espressif/esp-moonlight/docs/en/index.rst

ESP-Moonlight
=============

:link_to_translation:`zh_CN:[中文]`

ESP-Moonlight Support Policy
-----------------------------

From December 2023, we will offer limited support on this project, but Pull Request is still welcomed!

Supported versions and chips
-----------------------------

+---------------+-------------------+---------------+-----------------+
| ESP-Moonlight | Dependent ESP-IDF |    Target     |  Support State  |
+===============+===================+===============+=================+
| master        | >=release/v4.4    | ESP32 ESP32S3 | Limited Support |
+---------------+-------------------+---------------+-----------------+

Get Started
------------

.. role:: bolditalics
   :class: bolditalics

| **Building Products with ESP32** :bolditalics:`fast`: MoonLight

+------------------+
| _ |
+------------------+
| `Jumpstart Now`_ |
+------------------+

.. toctree::
   :hidden:

   Introduction <introduction>
   Getting Started <gettingstarted>
   The Driver <drivers>
   Wi-Fi Connection <wifi>
   Network Configuration <networkconfig>
   Remote Control (LAN) <remotecontrol_lan>
   Firmware Upgrades <firmwareupgrade>
   Speech Recognition <speech_recognition>


.. _Jumpstart Now: introduction.html
