espressif/esp-moonlight/docs/zh_CN/index.rst

ESP-Moonlight
=============

:link_to_translation:`en:[English]`

ESP-Moonlight 支持政策
-----------------------

自 2023 年 12 月起，我们仅提供有限的支持，但是 Pull Request 仍然是被欢迎的！

支持的版本和芯片
-----------------

+---------------+-------------------+---------------+-----------------+
| ESP-Moonlight | Dependent ESP-IDF |    Target     |  Support State  |
+===============+===================+===============+=================+
| master        | >=release/v4.4    | ESP32 ESP32S3 | Limited Support |
+---------------+-------------------+---------------+-----------------+

快速入门
--------

.. role:: bolditalics
   :class: bolditalics

| **快速构建 ESP32 产品**： MoonLight

+------------------+
| _ |
+------------------+
| `Jumpstart Now`_ |
+------------------+

.. toctree::
   :hidden:

   简介 <introduction>
   入门指南 <gettingstarted>
   驱动程序 <drivers>
   Wi-Fi 连接 <wifi>
   网络配置 <networkconfig>
   远程控制（局域网） <remotecontrol_lan>
   固件升级 <firmwareupgrade>
   语音识别控制 <speech_recognition>


.. _Jumpstart Now: introduction.html
