espressif/esp-moonlight/docs/zh_CN/introduction.rst

简介
============

ESP-Moonlight：使用 ESP32 快速构建一个月球灯
---------------------------------------------

ESP-Moonlight 是乐鑫推出的基于 ESP32 开发的月球灯示例项目，内含产品开发的完整步骤、最佳做法，可实现驱动 LED 灯、局域网内使用小程序端控制灯的亮度和色彩等功能。本项目以快速开发为特点，硬件结构简单，代码架构清晰完善，方便功能扩展，可用于教育领域。

esp-moonlight

    ESP-Moonlight

本项目中的月球灯有以下功能：

- 板载自动下载电路
- 电池充电功能
- 支持手机进行配网
- 支持手机控制
- 支持触碰控制
- 支持 OTA 升级
- 支持语音唤醒控制

开发板介绍
-----------

本项目使用的是 ESP32-Moonlight V2.0 开发板。

front

    ESP32-Moonlight 开发板正面

back

    ESP32-Moonlight 开发板背面
