espressif/esp-moonlight/model_3d/esp-moonlight-bottom-V2.1.stl

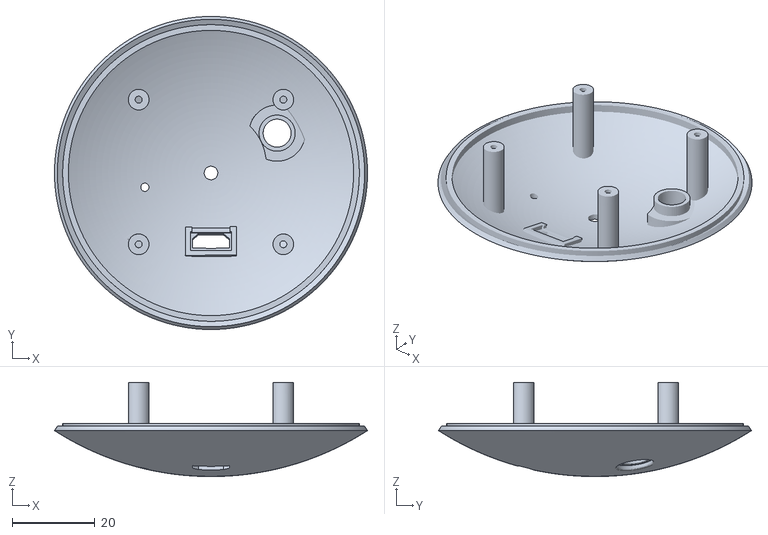
[picture p15: CAD file, 2020-07-27]
model_3d/esp-moonlight-bottom-V2.1.stl
75.7 x 75.7 x 22.8
