espressif/esp-moonlight/(list of files, cad)

Other CAD files:
model_3d/ESP-Moonlight-bottom_V2.0.stl
