espressif/esp-moonlight/(threads)

Thread 2 (2020-05-21):

例程recognize编译失败

2502797718, 2020-05-21:
提示是缺失一堆数学函数sin,log之类。

zhouli-esp, 2020-05-22:
If you can provide debug logs in the monitor, it will help solve the problem.
there are two tips:
 - Check your ESP-IDF version is [release/v4.0](https://github.com/espressif/esp-idf/tree/release/v4.0).
 - In addition, you can try to use the latest commit

2502797718, 2020-05-22:
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
[编译时错误信息.txt](https://github.com/espressif/esp-moonlight/files/4665932/default.txt)
这是编译信息，用的是v4.0

2502797718, 2020-05-22:
最新版本的源码可以编译通过

zhouli-esp, 2020-05-22:
This error may be due to  some problems in CMakeLists.txt. The latest code is recommended

zhouli-esp, 2020-05-28:
@2502797718 If your question is resolved, please close the issue. Thanks!

Closed 2020-05-28.

Thread 3 (2020-05-28):

speech_recognition 无法进行正常识别

hljswl, 2020-05-28:
1. 开发环境
模组或开发板：esp-moonlight开发板
ESP-IDF 版本：cd4fa46f5 / ESP-IDF v4.2-dev-1303-gcd4fa46f5-dirty
2. 问题描述
编译最新例程里面的 7_recognition 后不能进行语音识别。关键字唤醒没有反应。

zhouli-esp, 2020-05-28:
Now, the esp-moonlight based on ESP-IDF release/v4.0. Please see https://github.com/espressif/esp-moonlight/blob/master/docs/zh_CN/gettingstarted.rst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

Closed 2020-05-28.

Thread 5 (2022-06-20):

请问这个板子配网成功之后控制的APP在哪里下载呀

IcyFeather233, 2022-06-20:
在https://www.bilibili.com/video/BV1nQ4y1N7ZC?vd_source=145390bc56084552ecc0a576248fd1a1 这个视频教程的最后出现了一款“小夜灯”APP用来控制，但是我找不到这个APP的下载地址

IcyFeather233, 2022-06-20:
是我没注意，这个是那个微信小程序里面的

Closed 2022-06-20.
