espressif/esp-moonlight/hardware/ESP-Moonlight_V2.0_N_XX_20200421_V0.3/02_PCB Layout/PCB_ESP-Moonlight_V2.0_20200421.pdf

39.00mm

# C8C⁸x1C⁸x2

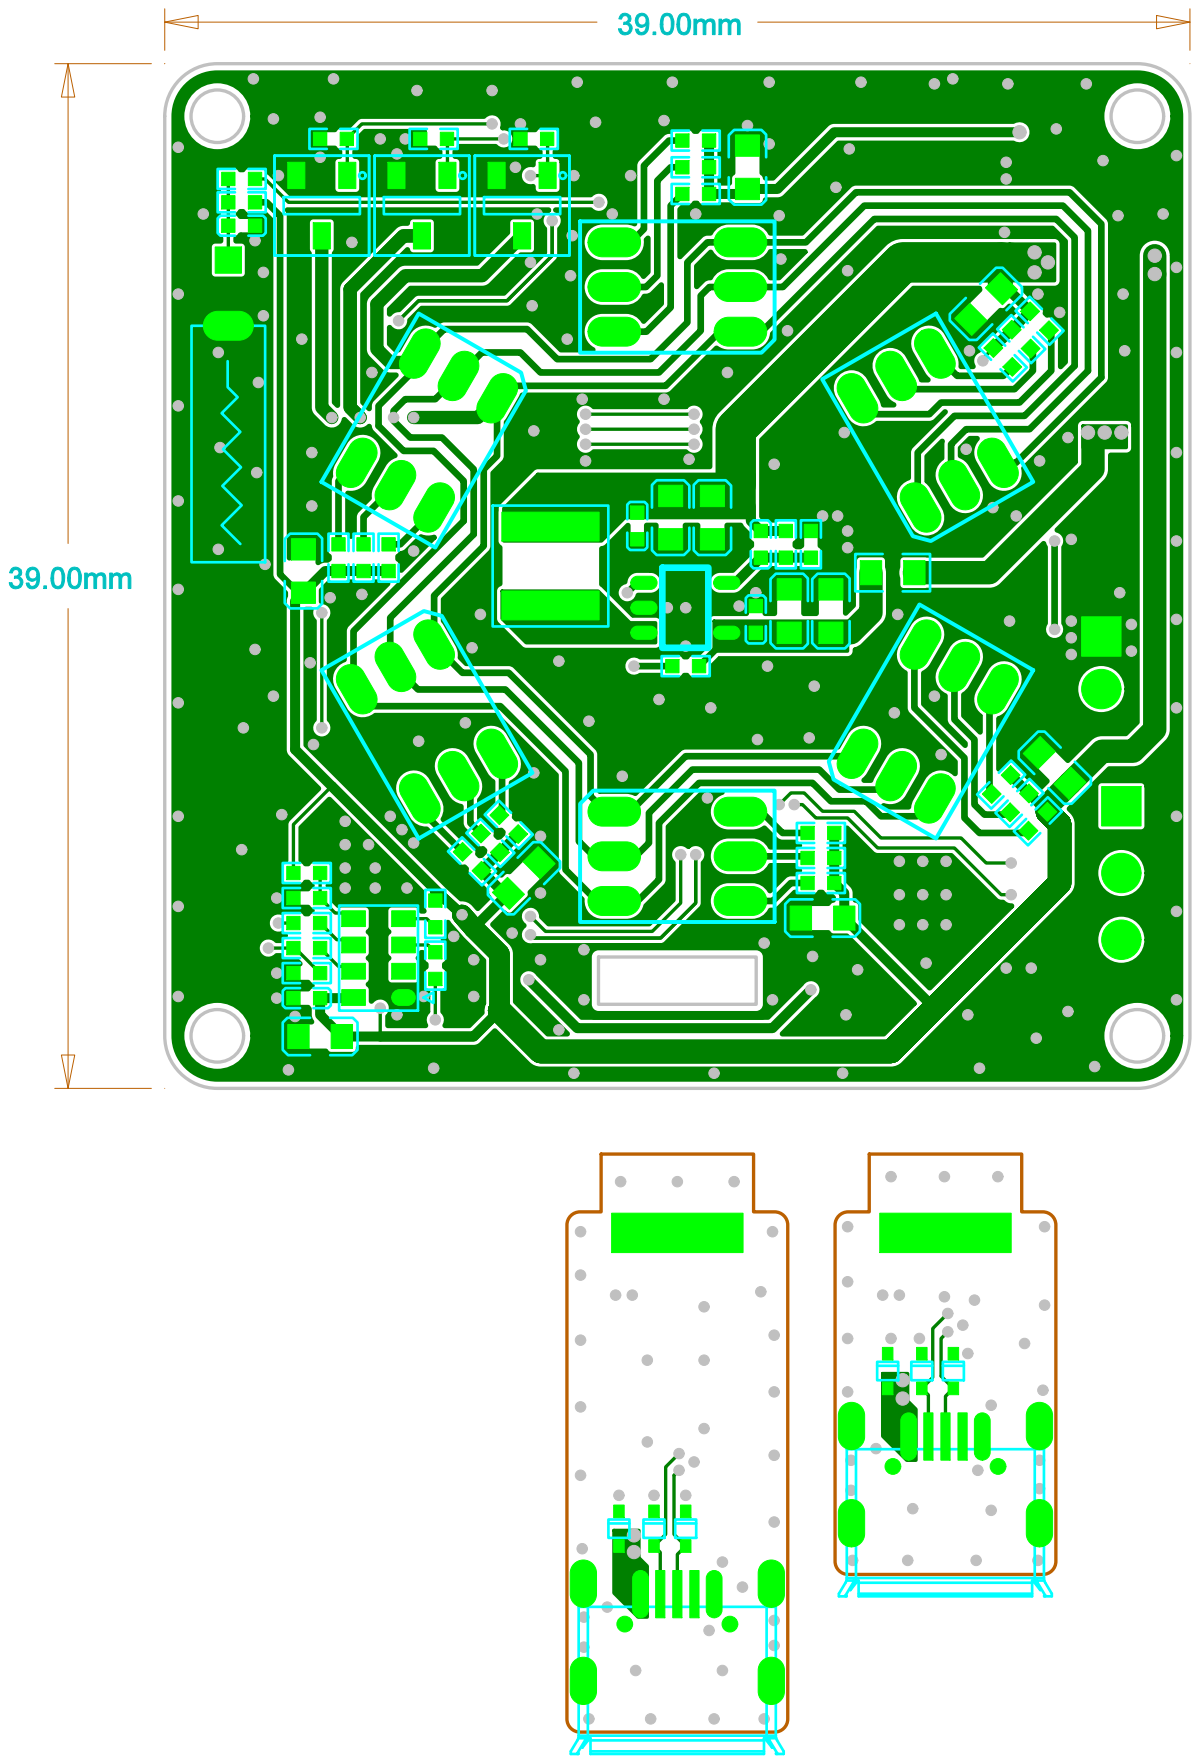
[picture p19: page 1]

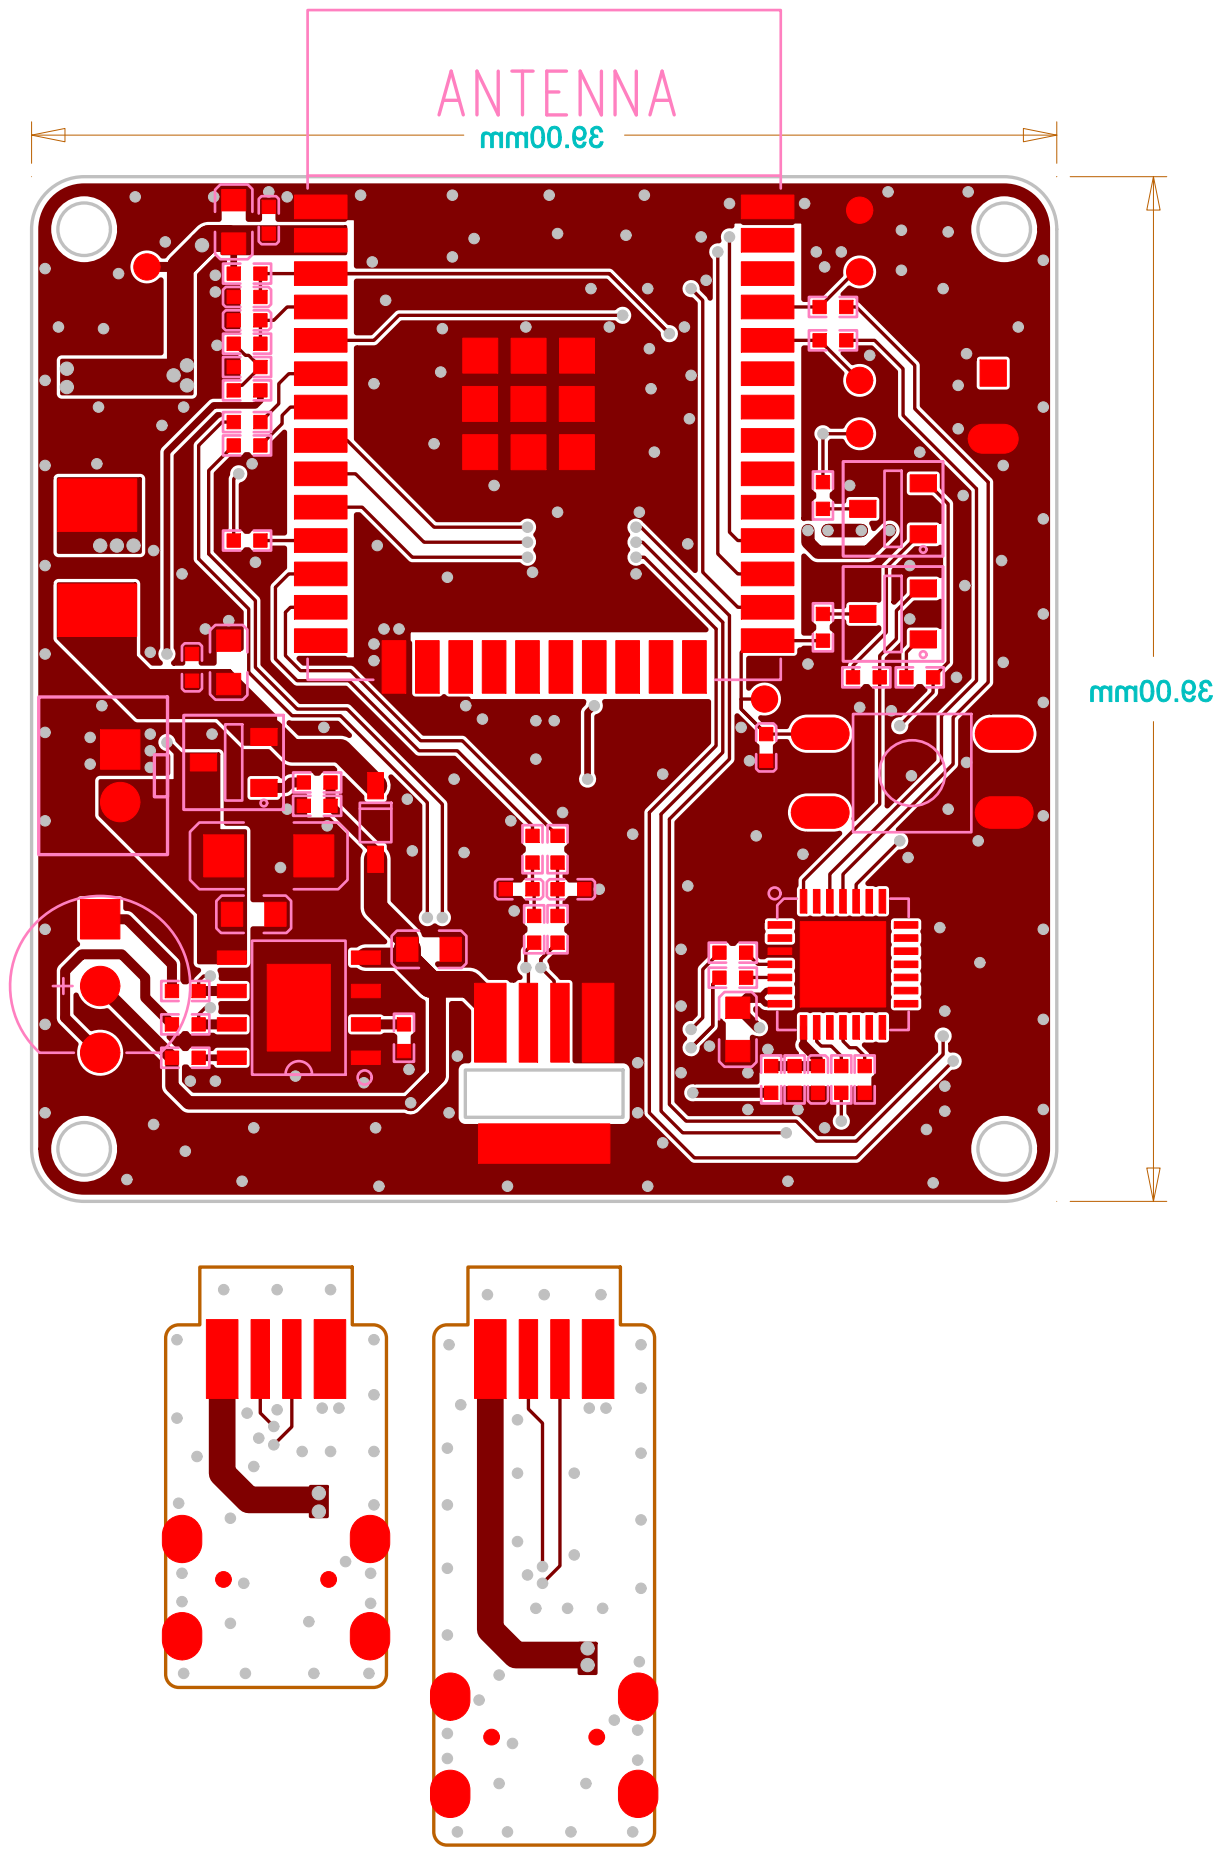
[picture p20: page 2]

39.00mm

C7

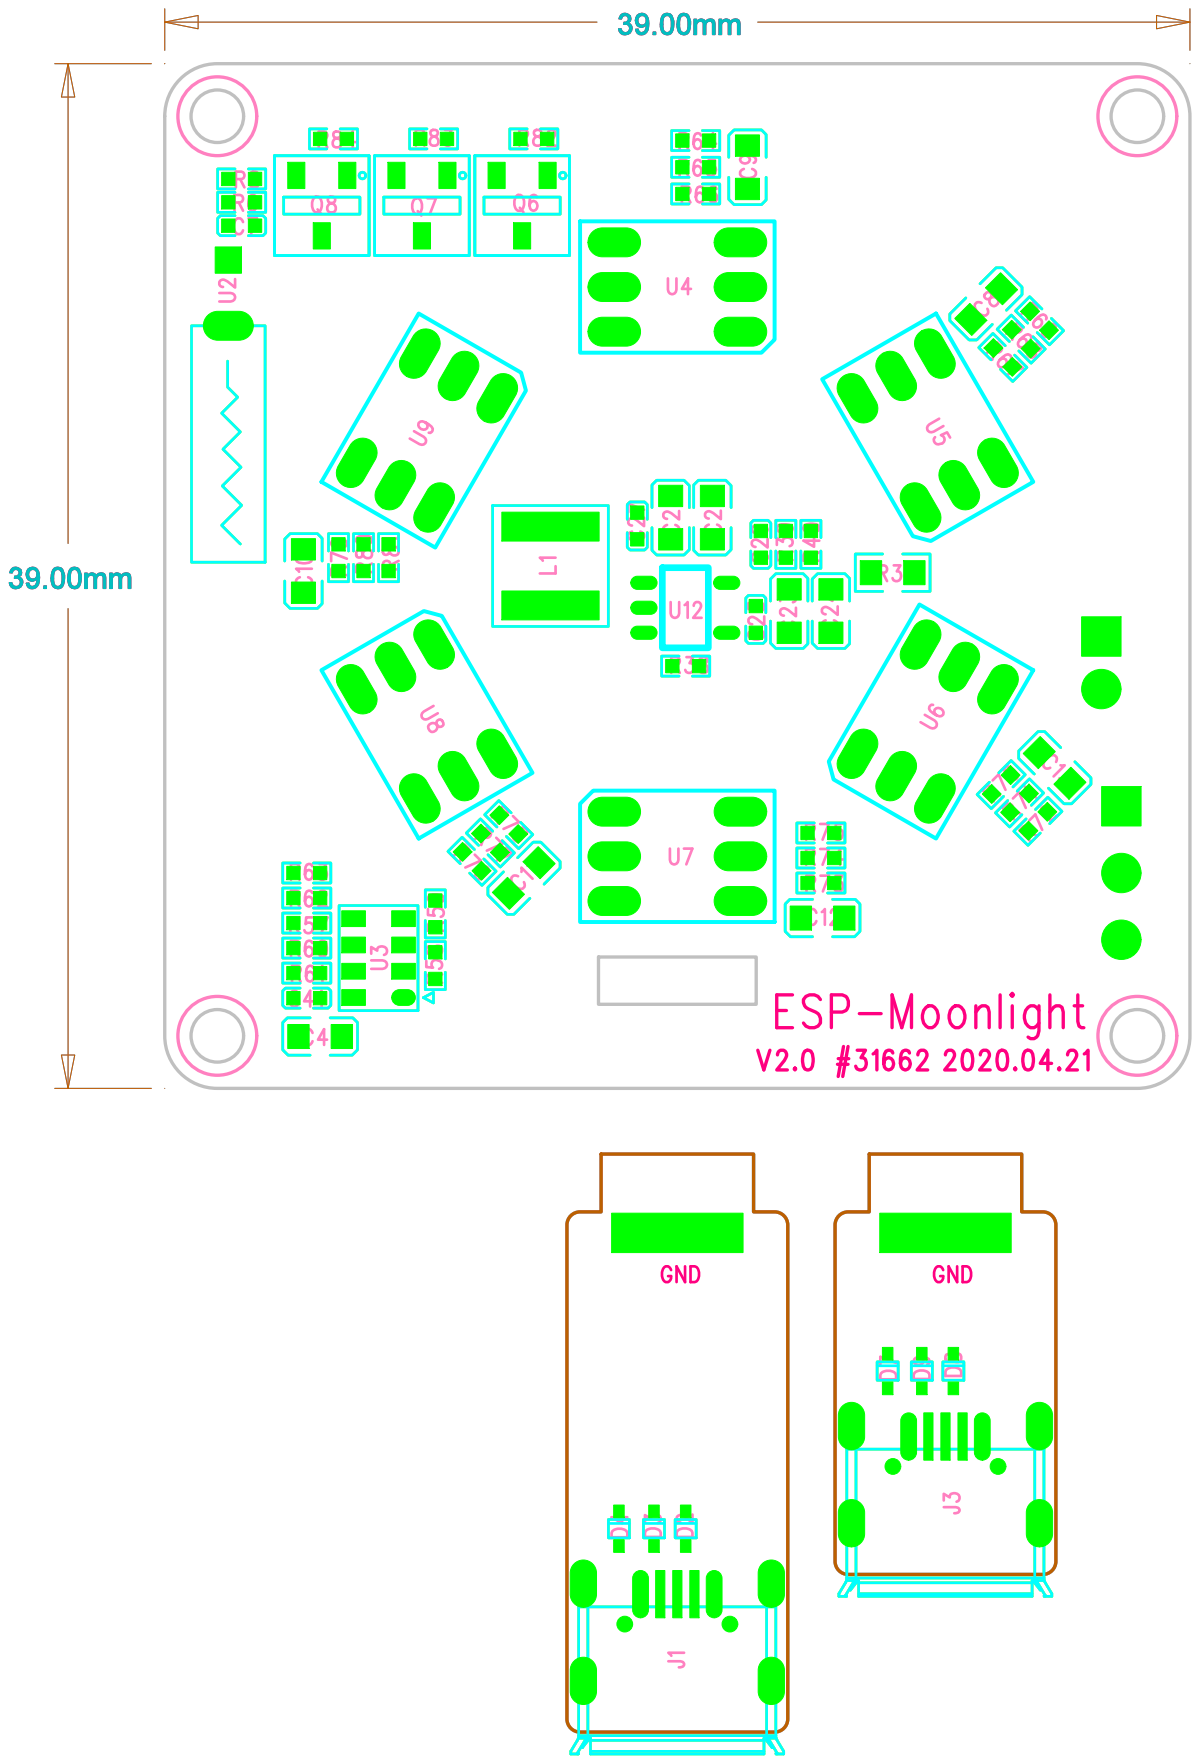
[picture p21: page 3]

3V3

# GND

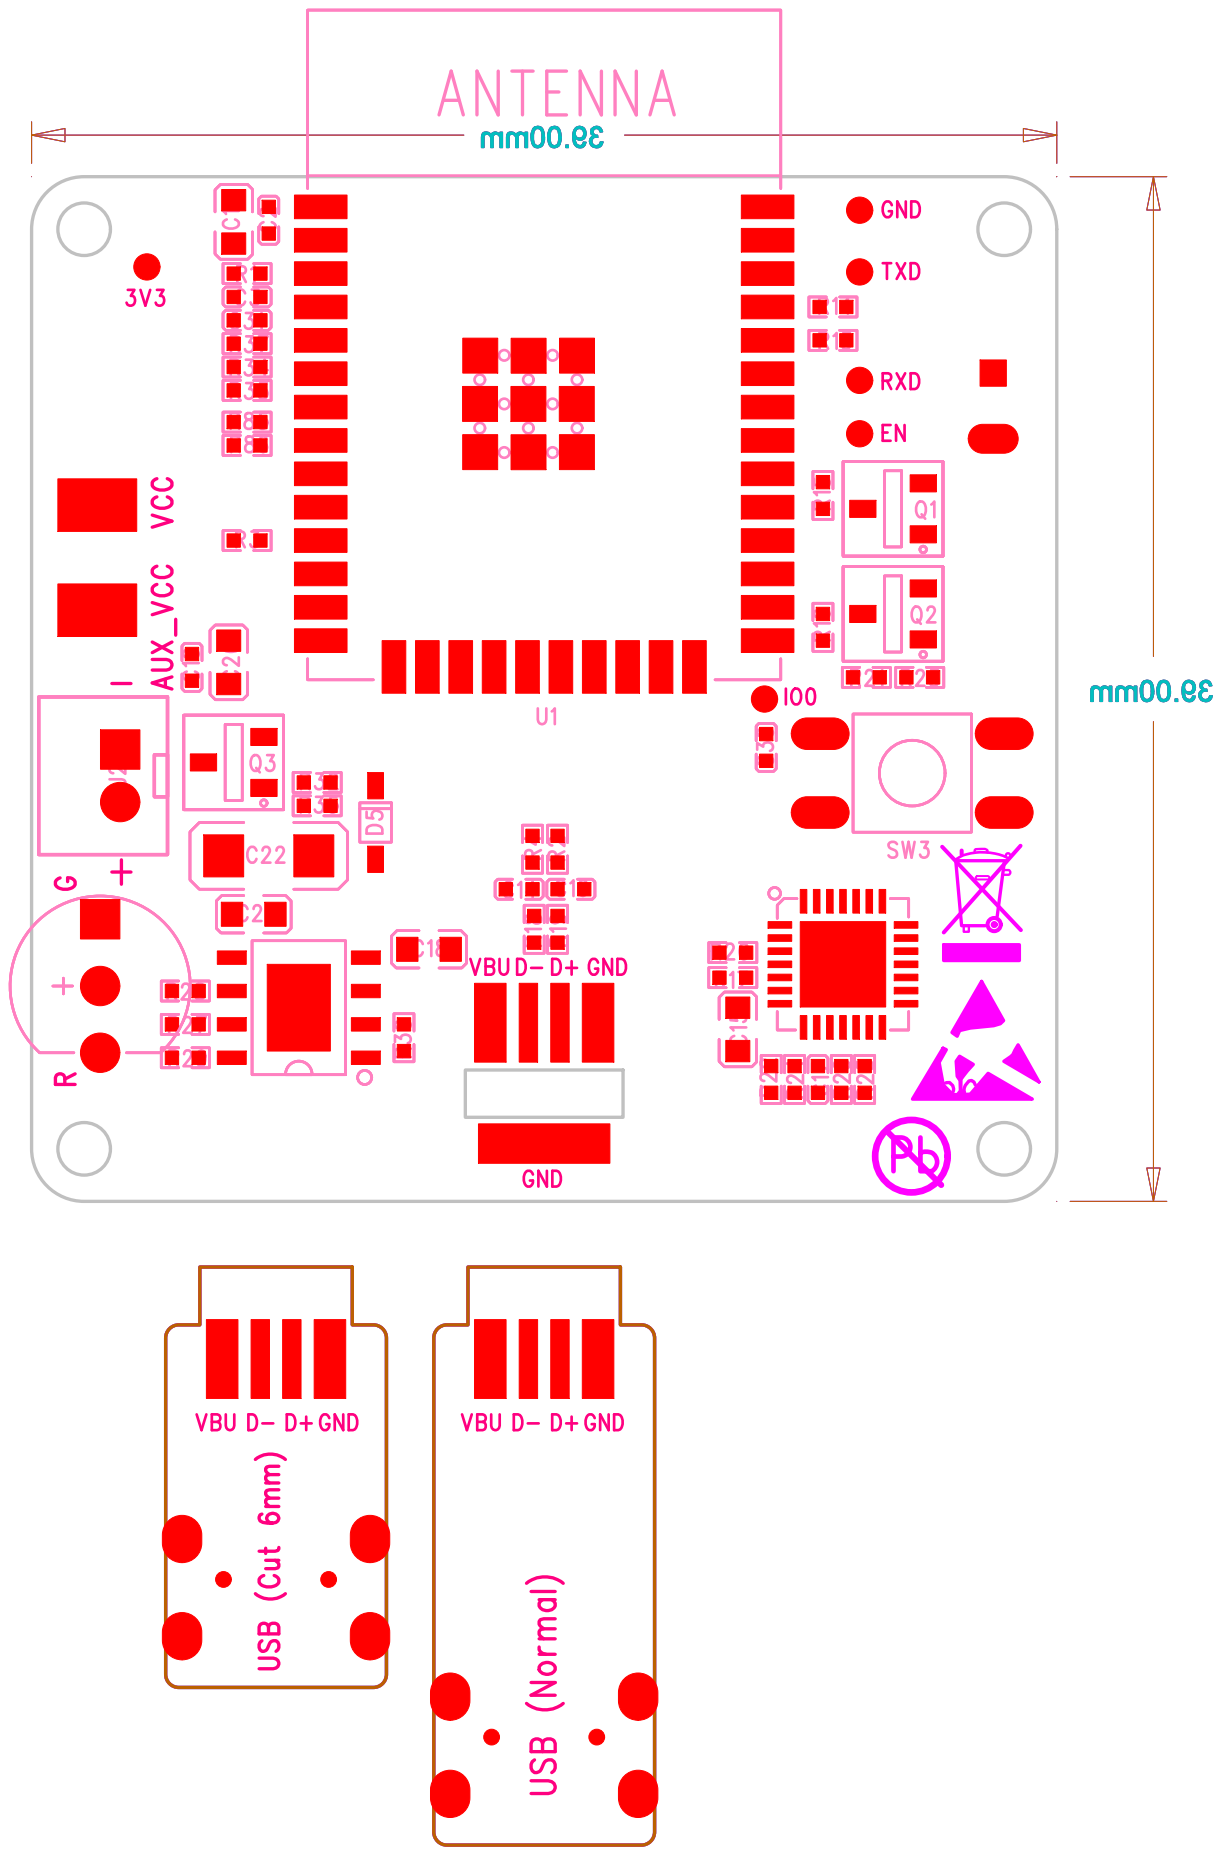
[picture p22: page 4]
