espressif/esp-moonlight/(list of files, drawings)

Other design files:
hardware/ESP-Moonlight_V2.0_N_XX_20200421_V0.3/01_Schematic/SCH_ESP-MOONLIGHT_V2_0_20200421A.DSN
hardware/ESP-Moonlight_V2.0_N_XX_20200421_V0.3/02_PCB Layout/PCB_ESP-Moonlight_V2.0_20200421.pcb
