espressif/esp-moonlight/components/moonlight_board/include/board_moonlight.h

// Copyright 2019 Espressif Systems (Shanghai) PTE LTD
//
// Licensed under the Apache License, Version 2.0 (the "License");
// you may not use this file except in compliance with the License.
// You may obtain a copy of the License at
//
//     http://www.apache.org/licenses/LICENSE-2.0
//
// Unless required by applicable law or agreed to in writing, software
// distributed under the License is distributed on an "AS IS" BASIS,
// WITHOUT WARRANTIES OR CONDITIONS OF ANY KIND, either express or implied.
// See the License for the specific language governing permissions and
// limitations under the License.

#pragma once
#include "sdkconfig.h"
#include "esp_log.h"
#include "esp_err.h"
#include "esp_random.h"
#include "esp_check.h"
#include "esp_idf_version.h"
#include "nvs_flash.h"
#include "led_rgb.h"
#include "iot_button.h"
#include "sensor.h"

#ifdef CONFIG_IDF_TARGET_ESP32S2

#define BOARD_BAT_ADC_CHANNEL 3
#define BOARD_GPIO_SENSOR_INT 5
#define BOARD_DMIC_I2S_SCK    15
#define BOARD_DMIC_I2S_WS     16
#define BOARD_DMIC_I2S_SDO    17
#define BOARD_GPIO_LED_R      36
#define BOARD_GPIO_LED_G      35
#define BOARD_GPIO_LED_B      37
#define BOARD_GPIO_BAT_CHRG   6
#define BOARD_GPIO_BAT_STBY   7

#elif defined CONFIG_IDF_TARGET_ESP32

#define BOARD_BAT_ADC_CHANNEL 0
#define BOARD_GPIO_SENSOR_INT 39
#define BOARD_DMIC_I2S_SCK    32
#define BOARD_DMIC_I2S_WS     33
#define BOARD_DMIC_I2S_SDO    25
#define BOARD_GPIO_LED_R      16
#define BOARD_GPIO_LED_G      4
#define BOARD_GPIO_LED_B      17
#define BOARD_GPIO_BAT_CHRG   34
#define BOARD_GPIO_BAT_STBY   35

#elif defined CONFIG_IDF_TARGET_ESP32S3

#define BOARD_BAT_ADC_CHANNEL    7
#define BOARD_GPIO_SENSOR_INT    9
#define BOARD_DMIC_I2S_SCK       39
#define BOARD_DMIC_I2S_WS        38
#define BOARD_DMIC_I2S_SDO       40
#define BOARD_GPIO_LED_R         1
#define BOARD_GPIO_LED_G         2
#define BOARD_GPIO_LED_B         16
#define BOARD_GPIO_BAT_CHRG      -1
#define BOARD_GPIO_BAT_STBY      -1
#if ESP_IDF_VERSION >= ESP_IDF_VERSION_VAL(5, 0, 0)
#define BOARD_SUPPORT_SPEAKER    1
#endif
#define BOARD_DSPEAKER_I2S_WS    45
#define BOARD_DSPEAKER_I2S_BCK   48
#define BOARD_DSPEAKER_I2S_SDO   47

#endif

#define BOARD_GPIO_BUTTON      0  /**< button gpio number */

led_rgb_t *board_rgb_init(void);
void board_led_rgb_ctrl(led_rgb_t *led_rgb, uint8_t led_mode);
void breath_light_task(void *arg);
button_handle_t board_button_init(void);
esp_err_t board_sensor_init(vibration_isr_t fn);
esp_err_t board_nvs_flash_init(void);
