espressif/esp-moonlight/examples/7_recognition/main/app_main.c

/* Speech Recognition Example

   This example code is in the Public Domain (or CC0 licensed, at your option.)

   Unless required by applicable law or agreed to in writing, this
   software is distributed on an "AS IS" BASIS, WITHOUT WARRANTIES OR
   CONDITIONS OF ANY KIND, either express or implied.
*/

#include "freertos/FreeRTOS.h"
#include "freertos/task.h"
#include "esp_log.h"
#include "esp_random.h"
#include "app_speech_if.h"
#include "board_moonlight.h"
#if BOARD_SUPPORT_SPEAKER
#include "audio_player.h"
#endif

static led_rgb_t *g_leds = NULL;
typedef struct {
    uint8_t r;
    uint8_t g;
    uint8_t b;
} led_color_t;

static led_color_t led_color = {0};
static led_color_t led_color_wake_bk = {0};

static TaskHandle_t g_breath_light_task_handle = NULL;

static void sr_wake(void *arg)
{
    g_leds->get_rgb(g_leds, &led_color_wake_bk.r, &led_color_wake_bk.g, &led_color_wake_bk.b);
    /**< Turn on the breathing light */
    xTaskCreate(breath_light_task, "breath_light_task", 1024 * 2, (void*)g_leds, configMAX_PRIORITIES - 1, &g_breath_light_task_handle);
#if BOARD_SUPPORT_SPEAKER
    FILE *fp;
    fp = fopen("/spiffs/echo_cn_wake.wav", "rb");
    if (fp) {
        audio_player_play(fp);
    }
#endif
}

static void sr_cmd(void *arg)
{
    if (NULL != g_breath_light_task_handle) {
        vTaskDelete(g_breath_light_task_handle);
        g_leds->set_rgb(g_leds, led_color_wake_bk.r, led_color_wake_bk.g, led_color_wake_bk.b);
        g_breath_light_task_handle = NULL;
    }

#if BOARD_SUPPORT_SPEAKER
    FILE *fp;
    fp = fopen("/spiffs/echo_cn_ok.wav", "rb");
    if (fp) {
        audio_player_play(fp);
    }
#endif

    int32_t cmd_id = (int32_t)arg;

    switch (cmd_id) {
        case 0:
        case 1:
        case 2:
            g_leds->set_rgb(g_leds, led_color.r, led_color.g, led_color.b);
            break;

        case 3:
        case 4:
        case 5: {
            uint8_t r, g, b;
            g_leds->get_rgb(g_leds, &r, &g, &b);

            if (0 == r && 0 == g && 0 == b) {
                break;
            }

            g_leds->get_rgb(g_leds, &led_color.r, &led_color.g, &led_color.b);
            g_leds->set_rgb(g_leds, 0, 0, 0);
        }
        break;

        case 6: {
            uint32_t h, s, v;
            g_leds->get_hsv(g_leds, &h, &s, &v);
            /**< Set a random color */
            h = esp_random() / 11930465;
            s = esp_random() / 42949673;
            s = s < 40 ? 40 : s;
            ESP_ERROR_CHECK(g_leds->set_hsv(g_leds, h, s, v));
        }
        break;

        case 7:
        case 8: {
            uint32_t h, s, v;
            g_leds->get_hsv(g_leds, &h, &s, &v);

            if (v < 90) {
                v += 10;
            }

            g_leds->set_hsv(g_leds, h, s, v);
        }
        break;

        case 9:
        case 10: {
            uint32_t h, s, v;
            g_leds->get_hsv(g_leds, &h, &s, &v);

            if (v > 20) {
                v -= 10;
            }

            g_leds->set_hsv(g_leds, h, s, v);
        }
        break;

        default:
            break;
    }
}

static void sr_cmd_exit(void *arg)
{
#if BOARD_SUPPORT_SPEAKER
        FILE *fp;
        fp = fopen("/spiffs/echo_cn_end.wav", "rb");
        if (fp) {
            audio_player_play(fp);
        }
#endif
    if (NULL != g_breath_light_task_handle) {
        vTaskDelete(g_breath_light_task_handle);
        g_leds->set_rgb(g_leds, led_color_wake_bk.r, led_color_wake_bk.g, led_color_wake_bk.b);
        g_breath_light_task_handle = NULL;
    }
}

void app_main(void)
{
    /**< Initialize NVS */
    ESP_ERROR_CHECK(board_nvs_flash_init());
    /**< configure led driver */
    g_leds = board_rgb_init();

    speech_recognition_init();

    g_leds->set_rgb(g_leds, 120, 120, 120);
    g_leds->get_rgb(g_leds, &led_color.r, &led_color.g, &led_color.b);
    sr_handler_install(SR_CB_TYPE_WAKE, sr_wake, NULL);
    sr_handler_install(SR_CB_TYPE_CMD, sr_cmd, NULL);
    sr_handler_install(SR_CB_TYPE_CMD_EXIT, sr_cmd_exit, NULL);
}
