espressif/esp-moonlight/(commit log)

2020-05-14 Add documents and 3D model
    [ESP_Moonlight_bottom_0420.stl, PCB_ESP-Moonlight_V2.0_20200421.pcb, SCH_ESP-MOONLIGHT_V2_0_20200421A.DSN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]
2020-05-14 Add example 4_network_config and 5_app_control
    [partitions.csv]
2020-05-14 Add example 6_ota
    [partitions.csv]
2020-05-14 Add example 7_recognition
    [partitions.csv]
2020-05-21 refactor: Remove the components folder in examples
    [partitions.csv]
2020-05-21 mod: Update 3D model
    [ESP-Moonlight-bottom_V2.0.stl, ESP_Moonlight_bottom_0420.stl]
2020-06-02 bugfix: fix vibration sensor interrupt issue
    [sensor.c]
2020-06-03 refactor: components blufi and led_rgb
2020-06-11 feature(sensor): Add api sensor_battery_get_info_simple
2020-07-22 Add: 3D model of PCB-V2.1
    [esp-moonlight-bottom-V2.1.stl]
2023-11-16 moonlight: support esp32s3 and update idf version
    [partitions.csv, partitions_esp32.csv, partitions_esp32s3.csv]
2023-11-28 bugfix: update esp sr version
    [sensor.c]
2023-11-30 feature: moonlight support speak
    [partitions_esp32s3.csv]
